dominikbayerl/esp32s3-rail/esp32s3-rail.kicad_pcb

## KiCad design esp32s3-rail.kicad_pcb (2025-05-09)

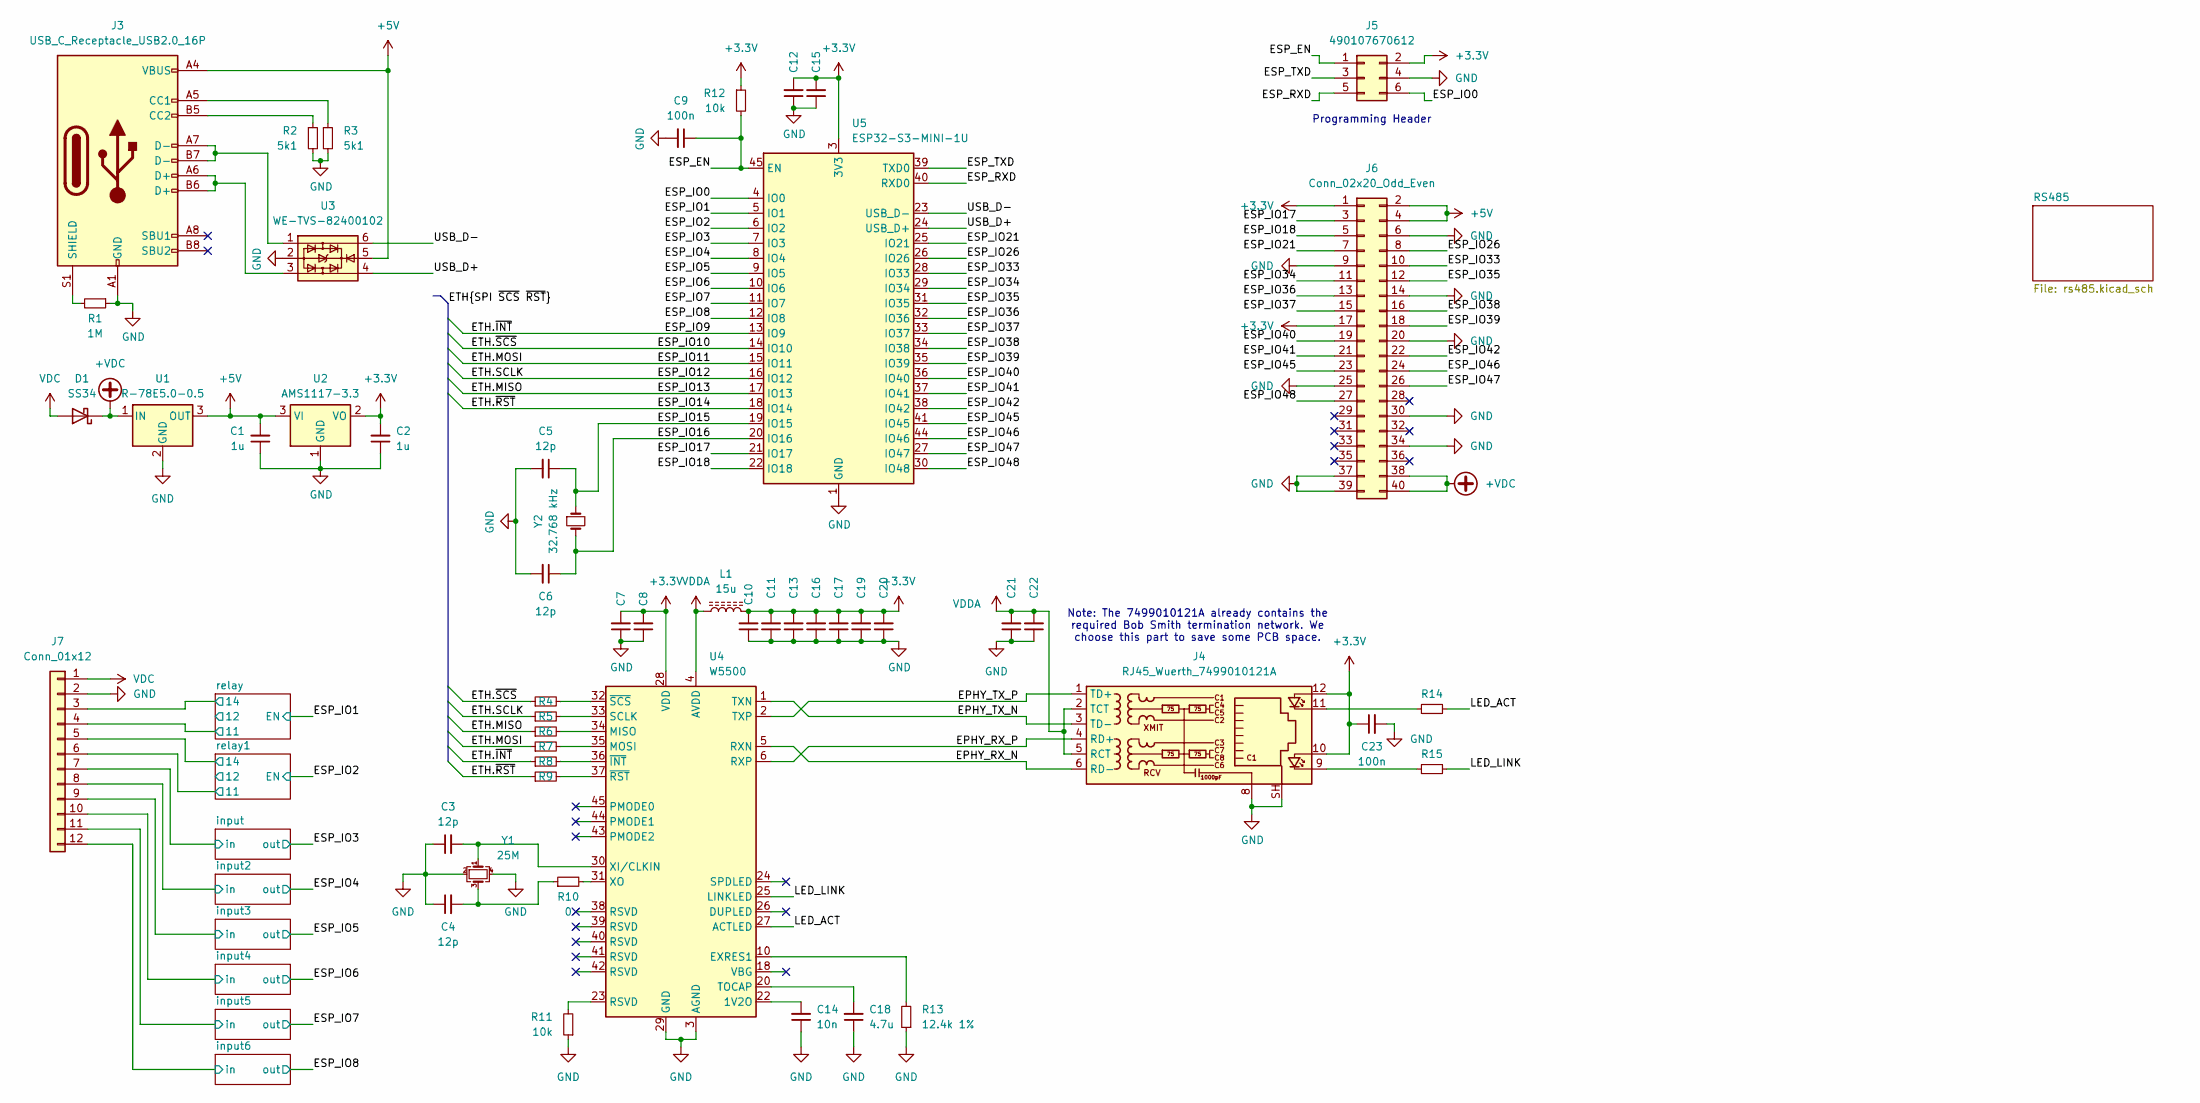
[picture p1: schematic esp32s3-rail.kicad_sch]

Parts:
C1, C2, C7, C8, C10, C11, C12, C13, C15, C16, C19, C20: 1u; C_0603_1608Metric_Pad1.08x0.95mm_HandSolder
C3, C4, C5, C6: 12p; C_0603_1608Metric_Pad1.08x0.95mm_HandSolder
C9, C21, C23: 100n; C_0603_1608Metric_Pad1.08x0.95mm_HandSolder
C14: 10n; C_0603_1608Metric_Pad1.08x0.95mm_HandSolder
C17: 10u; C_0603_1608Metric_Pad1.08x0.95mm_HandSolder
C18: 4.7u; C_0603_1608Metric_Pad1.08x0.95mm_HandSolder
C22: 1n; C_0603_1608Metric_Pad1.08x0.95mm_HandSolder
D1: SS34; D_SOD-123
J3: USB_C_Receptacle_USB2.0_16P; USB_C_Receptacle_HRO_TYPE-C-31-M-12
J4: RJ45_Wuerth_7499010121A; RJ45_Wuerth_7499010121A_Horizontal
J5: 490107670612; Würth_WR-WST_debug_490107670612_2x03_P2.54mm_Vertical
J6: Conn_02x20_Odd_Even; PinSocket_2x20_P2.54mm_Vertical
J7: Conn_01x12; Molex_SPOX_5268-12A_1x12_P2.50mm_Horizontal
L1: 15u; L_0603_1608Metric_Pad1.05x0.95mm_HandSolder
R1: 1M; R_0603_1608Metric_Pad0.98x0.95mm_HandSolder
R2, R3: 5k1; R_0603_1608Metric_Pad0.98x0.95mm_HandSolder
R4, R5, R6, R7, R8, R9: 20; R_0603_1608Metric_Pad0.98x0.95mm_HandSolder
R10: 0; R_0603_1608Metric_Pad0.98x0.95mm_HandSolder
R11, R12: 10k; R_0603_1608Metric_Pad0.98x0.95mm_HandSolder
R13: 12.4k 1%; R_0603_1608Metric_Pad0.98x0.95mm_HandSolder
R14, R15: 1k; R_0603_1608Metric_Pad0.98x0.95mm_HandSolder
U1: R-78E5.0-0.5; Converter_DCDC_RECOM_R-78E-0.5_THT
U2: AMS1117-3.3; SOT-223-3_TabPin2
U3: WE-TVS-82400102; SOT-23-6
U4: W5500; LQFP-48_7x7mm_P0.5mm
U5: ESP32-S3-MINI-1U; ESP32-S2-MINI-1U
Y1: 25M; Crystal_SMD_3225-4Pin_3.2x2.5mm_HandSoldering
Y2: 32.768 kHz; Crystal_SMD_3215-2Pin_3.2x1.5mm

Connections:
+3.3V: C2.2, C7.2, C8.2, C10.2, C11.2, C12.2, C13.2, C15.2, C16.2, C17.2, C19.2, C20.2, C23.1, J4.10, J4.12, J5.2, J6.1, J6.17, L1.2, R12.1, U2.2 (VO), U4.28 (VDD), U5.3 (3V3); also elsewhere on the board
+5V: C1.2, J3.A4 (VBUS), J3.A9 (VBUS), J3.B4 (VBUS), J3.B9 (VBUS), J6.2, J6.4, U1.3 (OUT), U2.3 (VI), U3.5; also elsewhere on the board
+VDC: D1.1 (K), J6.38, J6.40, U1.1 (IN)
/EPHY_RX_N: J4.6 (RD-), U4.5 (RXN)
/EPHY_RX_P: J4.4 (RD+), U4.6 (RXP)
/EPHY_TX_N: J4.3 (TD-), U4.1 (TXN)
/EPHY_TX_P: J4.1 (TD+), U4.2 (TXP)
/ESP_EN: C9.1, J5.1, R12.2, U5.45 (EN)
/ESP_IO0: J5.6, U5.4 (IO0)
/ESP_IO1: U5.5 (IO1); also elsewhere on the board
/ESP_IO2: U5.6 (IO2); also elsewhere on the board
/ESP_IO3: U5.7 (IO3); also elsewhere on the board
/ESP_IO4: U5.8 (IO4); also elsewhere on the board
/ESP_IO5: U5.9 (IO5); also elsewhere on the board
/ESP_IO6: U5.10 (IO6); also elsewhere on the board
/ESP_IO7: U5.11 (IO7); also elsewhere on the board
/ESP_IO8: U5.12 (IO8); also elsewhere on the board
/ESP_IO15: C5.1, U5.19 (IO15), Y2.1
/ESP_IO16: C6.1, U5.20 (IO16), Y2.2
/ESP_IO17: J6.3, U5.21 (IO17)
/ESP_IO18: J6.5, U5.22 (IO18)
/ESP_IO21: J6.7, U5.25 (IO21)
/ESP_IO26: J6.8, U5.26 (IO26)
/ESP_IO33: J6.10, U5.28 (IO33)
/ESP_IO34: J6.11, U5.29 (IO34)
/ESP_IO35: J6.12, U5.31 (IO35)
/ESP_IO36: J6.13, U5.32 (IO36)
/ESP_IO37: J6.15, U5.33 (IO37)
/ESP_IO38: J6.16, U5.34 (IO38)
/ESP_IO39: J6.18, U5.35 (IO39)
/ESP_IO40: J6.19, U5.36 (IO40)
/ESP_IO41: J6.21, U5.37 (IO41)
/ESP_IO42: J6.22, U5.38 (IO42)
/ESP_IO45: J6.23, U5.41 (IO45)
/ESP_IO46: J6.24, U5.44 (IO46)
/ESP_IO47: J6.26, U5.27 (IO47)
/ESP_IO48: J6.27, U5.30 (IO48)
/ESP_RXD: J5.5, U5.40 (RXD0)
/ESP_TXD: J5.3, U5.39 (TXD0)
/ETH.MISO: R6.1, U5.17 (IO13)
/ETH.MOSI: R7.1, U5.15 (IO11)
/ETH.SCLK: R5.1, U5.16 (IO12)
/ETH.~INT: R8.1, U5.13 (IO9)
/ETH.~RST: R9.1, U5.18 (IO14)
/ETH.~SCS: R4.1, U5.14 (IO10)
/LED_ACT: R14.2, U4.27 (ACTLED)
/LED_LINK: R15.2, U4.25 (LINKLED)
/USB_D+: U3.4, U5.24 (USB_D+)
/USB_D-: U3.6, U5.23 (USB_D-)
/input2/in: J7.8; also elsewhere on the board
/input3/in: J7.9; also elsewhere on the board
/input4/in: J7.10; also elsewhere on the board
/input5/in: J7.11; also elsewhere on the board
/input6/in: J7.12; also elsewhere on the board
/input/in: J7.7; also elsewhere on the board
/relay1/11: J7.6; also elsewhere on the board
/relay1/14: J7.5; also elsewhere on the board
/relay/11: J7.4; also elsewhere on the board
/relay/14: J7.3; also elsewhere on the board
GND: C1.1, C2.1, C3.1, C4.1, C5.2, C6.2, C7.1, C8.1, C9.2, C10.1, C11.1, C12.1, C13.1, C14.1, C15.1, C16.1, C17.1, C18.1, C19.1, C20.1, C21.1, C22.1, C23.2, J3.A1 (GND), J3.A12 (GND), J3.B1 (GND), J3.B12 (GND), J4.8, J4.SH, J5.4, J6.6, J6.9, J6.14, J6.20, J6.25, J6.30, J6.34, J6.37, J6.39, J7.2, R1.1, R2.2, R3.2, R11.1, R13.1, U1.2 (GND), U2.1 (GND), U3.2, U4.3 (AGND), U4.9 (AGND), U4.14 (AGND), U4.16 (AGND), U4.19 (AGND), U4.29 (GND), U4.48 (AGND), U5.1 (GND), U5.2 (GND), U5.42 (GND), U5.43 (GND), U5.46 (GND), U5.47 (GND), U5.48 (GND), U5.49 (GND), U5.50 (GND), U5.51 (GND), U5.52 (GND), U5.53 (GND), U5.54 (GND), U5.55 (GND), U5.56 (GND), U5.57 (GND), U5.58 (GND), U5.59 (GND), U5.60 (GND), U5.61 (GND), U5.62 (GND), U5.63 (GND), U5.64 (GND), U5.65 (GND), Y1.2, Y1.4; also elsewhere on the board
unnamed: C4.2, R10.1, Y1.3
unnamed: J3.A5 (CC1), R3.1
unnamed: J3.B5 (CC2), R2.1
unnamed: J3.A6 (D+), J3.B6 (D+), U3.3
unnamed: J3.A7 (D-), J3.B7 (D-), U3.1
unnamed: J3.S1 (SHIELD), R1.2
unnamed: J4.9, R15.1
unnamed: J4.11, R14.1
unnamed: R11.2, U4.23 (RSVD)
unnamed: C14.2, U4.22 (1V2O)
unnamed: R13.2, U4.10 (EXRES1)
unnamed: R6.2, U4.34 (MISO)
unnamed: R7.2, U4.35 (MOSI)
unnamed: R5.2, U4.33 (SCLK)
unnamed: C18.2, U4.20 (TOCAP)
unnamed: C3.2, U4.30 (XI/CLKIN), Y1.1
unnamed: R10.2, U4.31 (XO)
unnamed: R8.2, U4.36 (~INT)
unnamed: R9.2, U4.37 (~RST)
unnamed: R4.2, U4.32 (~SCS)
VDC: D1.2 (A), J7.1
VDDA: C21.2, C22.2, J4.2 (TCT), J4.5 (RCT), L1.1, U4.4 (AVDD), U4.8 (AVDD), U4.11 (AVDD), U4.15 (AVDD), U4.17 (AVDD), U4.21 (AVDD)

Notes on the sheet:
Programming Header
Note: The 7499010121A already contains the required Bob Smith termination network. We choose this part to save some PCB space.

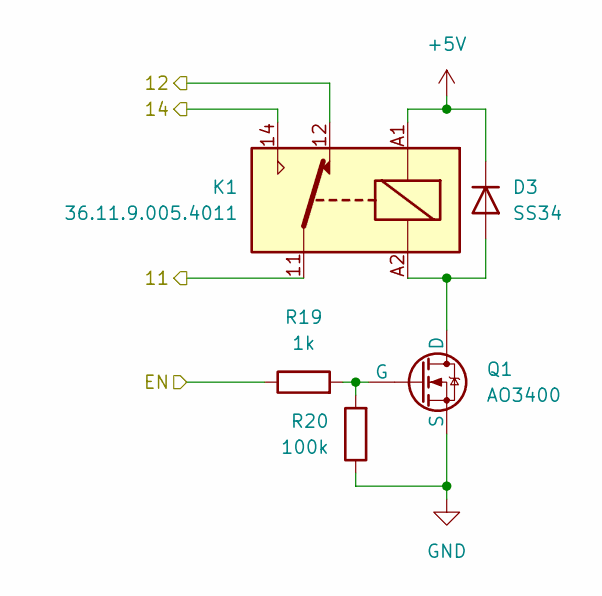
[picture p2: schematic relay.kicad_sch]

Parts:
D3: SS34; D_SOD-123
K1: 36.11.9.005.4011; Relay_SPDT_Finder_36.11
Q1: AO3400; SOT-23_Handsoldering
R19: 1k; R_0603_1608Metric_Pad0.98x0.95mm_HandSolder
R20: 100k; R_0603_1608Metric_Pad0.98x0.95mm_HandSolder

Connections:
+5V: D3.1 (K), K1.A1; also elsewhere on the board
/ESP_IO2: R19.1; also elsewhere on the board
/relay1/11: K1.11; also elsewhere on the board
/relay1/12: K1.12
/relay1/14: K1.14; also elsewhere on the board
GND: Q1.3 (S), R20.1; also elsewhere on the board
unnamed: D3.2 (A), K1.A2, Q1.1 (D)
unnamed: Q1.2 (G), R19.2, R20.2

Parts of its further copies:
D6: SS34; D_SOD-123
K2: 36.11.9.005.4011; Relay_SPDT_Finder_36.11
Q2: AO3400; SOT-23_Handsoldering
R27: 1k; R_0603_1608Metric_Pad0.98x0.95mm_HandSolder
R28: 100k; R_0603_1608Metric_Pad0.98x0.95mm_HandSolder

Connections of its further copies:
+5V: D6.1 (K), K2.A1; also elsewhere on the board
/ESP_IO1: R27.1; also elsewhere on the board
/relay/11: K2.11; also elsewhere on the board
/relay/12: K2.12
/relay/14: K2.14; also elsewhere on the board
GND: Q2.3 (S), R28.1; also elsewhere on the board
unnamed: D6.2 (A), K2.A2, Q2.1 (D)
unnamed: Q2.2 (G), R27.2, R28.2

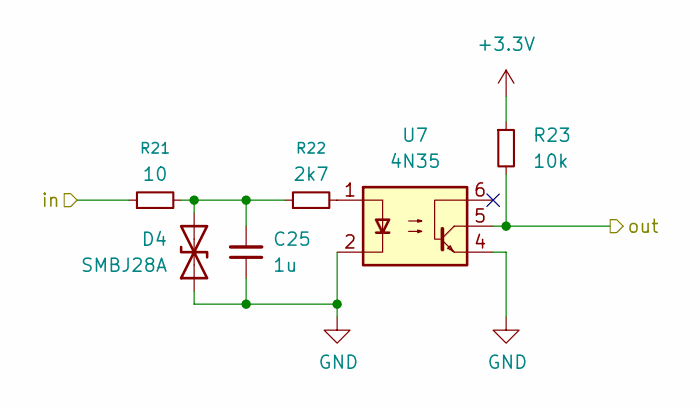
[picture p3: schematic input.kicad_sch]

Parts:
C25: 1u; C_0603_1608Metric_Pad1.08x0.95mm_HandSolder
D4: SMBJ28A; D_SMA_Handsoldering
R21: 10; R_0603_1608Metric_Pad0.98x0.95mm_HandSolder
R22: 2k7; R_0603_1608Metric_Pad0.98x0.95mm_HandSolder
R23: 10k; R_0603_1608Metric_Pad0.98x0.95mm_HandSolder
U7: 4N35; DIP-6_W7.62mm

Connections:
+3.3V: R23.1; also elsewhere on the board
/ESP_IO3: R23.2, U7.5; also elsewhere on the board
/input/in: R21.1; also elsewhere on the board
GND: C25.1, D4.1 (A1), U7.2, U7.4; also elsewhere on the board
unnamed: C25.2, D4.2 (A2), R21.2, R22.1
unnamed: R22.2, U7.1

Parts of its further copies:
C26, C27, C28, C29, C30: 1u; C_0603_1608Metric_Pad1.08x0.95mm_HandSolder
D5, D7, D8, D9, D10: SMBJ28A; D_SMA_Handsoldering
R24, R29, R32, R35, R38: 10; R_0603_1608Metric_Pad0.98x0.95mm_HandSolder
R25, R30, R33, R36, R39: 2k7; R_0603_1608Metric_Pad0.98x0.95mm_HandSolder
R26, R31, R34, R37, R40: 10k; R_0603_1608Metric_Pad0.98x0.95mm_HandSolder
U8, U9, U10, U11, U12: 4N35; DIP-6_W7.62mm

Connections of its further copies:
+3.3V: R26.1, R31.1, R34.1, R37.1, R40.1; also elsewhere on the board
/ESP_IO4: R31.2, U9.5; also elsewhere on the board
/ESP_IO5: R26.2, U8.5; also elsewhere on the board
/ESP_IO6: R34.2, U10.5; also elsewhere on the board
/ESP_IO7: R37.2, U11.5; also elsewhere on the board
/ESP_IO8: R40.2, U12.5; also elsewhere on the board
/input2/in: R29.1; also elsewhere on the board
/input3/in: R24.1; also elsewhere on the board
/input4/in: R32.1; also elsewhere on the board
/input5/in: R35.1; also elsewhere on the board
/input6/in: R38.1; also elsewhere on the board
GND: C26.1, C27.1, C28.1, C29.1, C30.1, D5.1 (A1), D7.1 (A1), D8.1 (A1), D9.1 (A1), D10.1 (A1), U8.2, U8.4, U9.2, U9.4, U10.2, U10.4, U11.2, U11.4, U12.2, U12.4; also elsewhere on the board
unnamed: C26.2, D5.2 (A2), R24.2, R25.1
unnamed: C27.2, D7.2 (A2), R29.2, R30.1
unnamed: C28.2, D8.2 (A2), R32.2, R33.1
unnamed: C29.2, D9.2 (A2), R35.2, R36.1
unnamed: C30.2, D10.2 (A2), R38.2, R39.1
unnamed: R25.2, U8.1
unnamed: R30.2, U9.1
unnamed: R33.2, U10.1
unnamed: R36.2, U11.1
unnamed: R39.2, U12.1

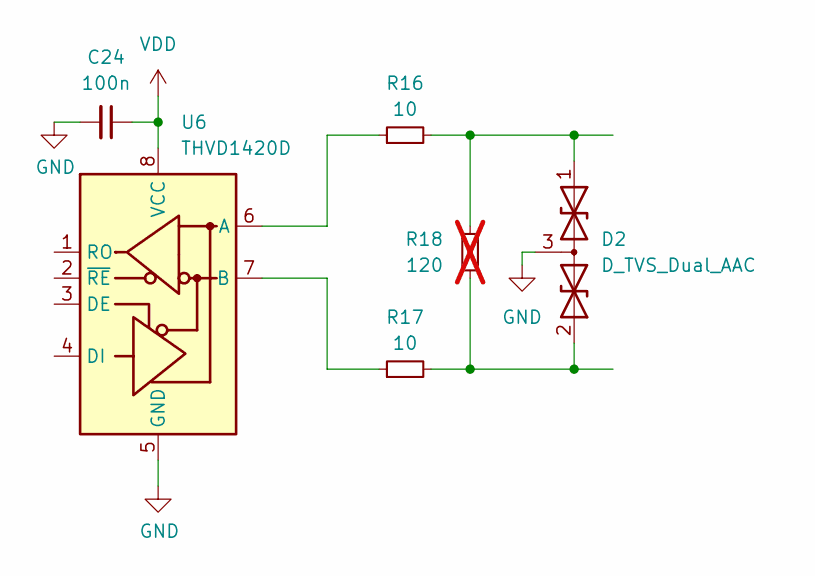
[picture p4: schematic rs485.kicad_sch]

Parts:
C24: 100n
D2: D_TVS_Dual_AAC; SOT-23
R16, R17: 10; R_1206_3216Metric
R18: 120; R_1206_3216Metric; not fitted
U6: THVD1420D; SOIC-8_3.9x4.9mm_P1.27mm

Connections:
unnamed: C24.1, U6.8 (VCC)
unnamed: C24.2, D2.3 (common), U6.5 (GND)
unnamed: D2.1 (A1), R16.2, R18.2
unnamed: D2.2 (A2), R17.2, R18.1
unnamed: R16.1, U6.6 (A)
unnamed: R17.1, U6.7 (B)

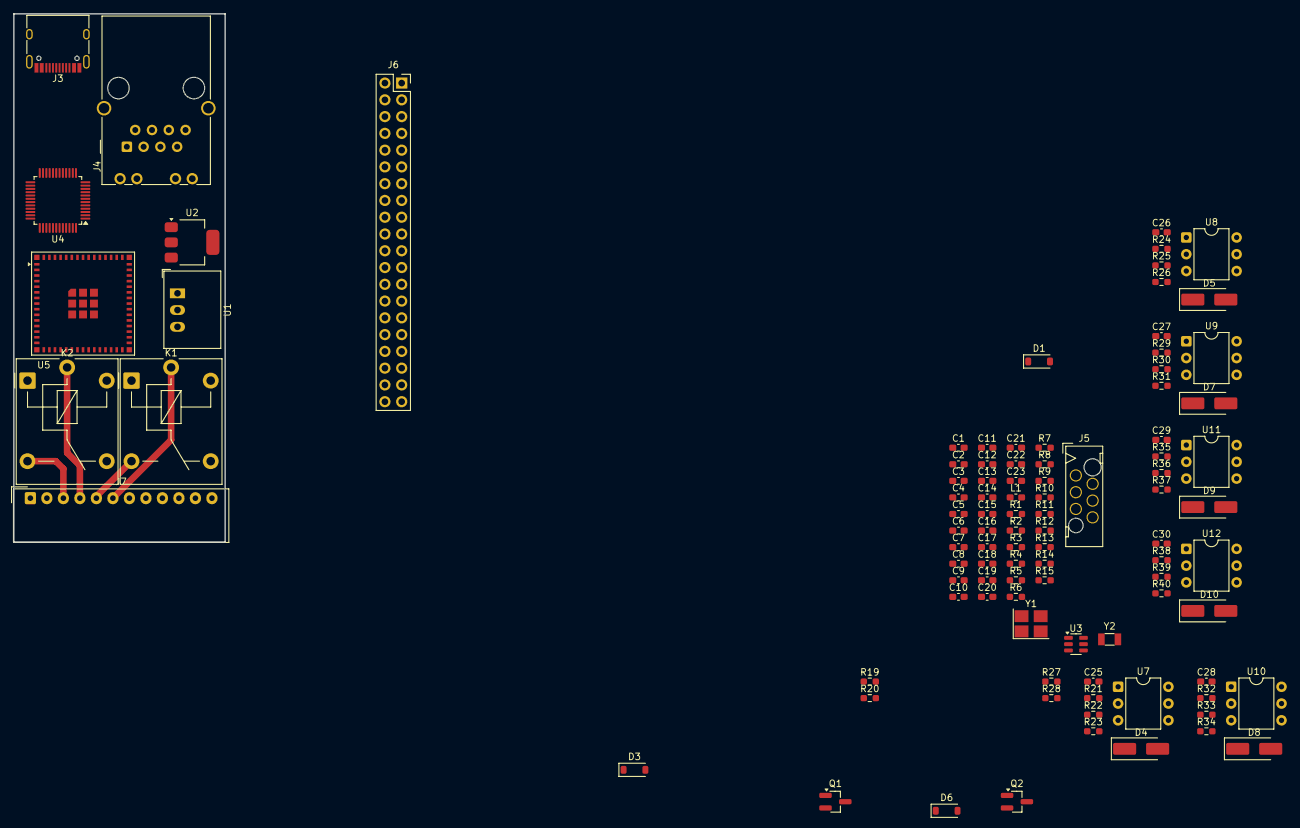
[picture p5: board esp32s3-rail.kicad_pcb from above]

Board: 2 copper layers, 32.0 x 80.0 mm, 98 parts (0 on the bottom side), 98 nets.
