dominikbayerl/esp32s3-rail/(commit log)

2025-04-17 Initial import.
    [esp32s3-rail.kicad_pcb, esp32s3-rail.kicad_sch]
2025-04-17 Add Wuerth WR-WST connector footprints.
2025-04-25 Update schematic: - Add RS485 ports - Add USB ports - Add 24V I/O ports
    [esp32s3-rail.kicad_sch, input.kicad_sch, output.kicad_sch, rs485.kicad_sch, usb.kicad_sch]
2025-05-07 Finish rev0 schematics.
    [esp32s3-rail.kicad_sch, input.kicad_sch, relay.kicad_sch, rs485.kicad_sch]
2025-05-07 Assign footprints.
    [esp32s3-rail.kicad_pcb, esp32s3-rail.kicad_sch, input.kicad_sch, relay.kicad_sch]
2025-05-09 Update stacking header.
    [esp32s3-rail.kicad_pcb, esp32s3-rail.kicad_sch]
